mmccoyd/hillside/doc/design.md

Drill tollerence is typically +- 2 mills
Hotswap mill-max sockets need 60 mill min hole
So created footprint with 62 mill holes.
