mmccoyd/hillside/hillside46/doc/image/hill46_keys.png

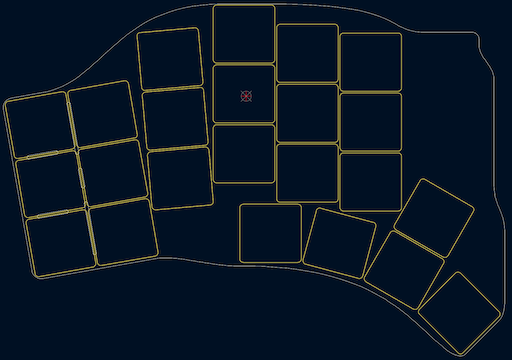
hillside46/doc/image/hill46_keys.png
