mmccoyd/hillside/docs/materials.md

# Materials

## PCB Manufacturing
The gerber and drill files to send to a manufacturer are HERE. Just zip up that folder and order.
Using AllPCB worked fine with order settings of: 10mil trace, 0.4mm via hole, 2 layers, 1.6mm board, 1oz copper, and 98 x 137mm size.

If you would like to make changes, the KiCad files are HERE. 

Cost: $18 plus shipping (for 5 PCBs or 2.5 keyboards).

## Board Hardware

| Part  | Type  | Count | US Shops  | Cost  |
| --- | ----  | ----: | --- | ---: |
| MCU | Elite-C, etc | 2 |  Keebio, MKUltra, LittleKeyboards | $36  |
| Diodes | 1N4148 SOD 123 | 48  |  MKUltra(F), Keebio  | $4 |
| Reset Switch  | MJTP1117 | 2 | Keebio | $1 |
| TRRS Jack | MJ-4PP-9 or PJ-320A | 2 | Keebio | $1 |

## Switches, Keycaps, Cables

You'll need switches, keycaps and a USB cable. The halfs can be connected by a common TRS cable or a more rare TRRS one. 

| Part  | Type  | Count | US Shops  | Cost  |
| --- | ----  | ----: | --- | ---: |
| Switches | Choc v1 | 48 |  MKUltra, LittleKeyBoards  | $33 |
| Keycaps | Choc v1 | 48 |  MBK at: MKUltra (B, W, Colors), LittleKeyboards(BW big kit, Legend, Glow)  | $19 |
| TRS or TRRS cable | 3.5mm  | 1 | TripLite (angled or straight plastic, one foot), Keebio(straight brass, metal sleeved, three foot), ZapCables(custom, metal jack), Mouser SparkFun (plastic 90, one foot)| $7 |
| USB-C cable | | 1 | |  $12 | 

# Optional Additions

## Board Hardware

The simpilist use is flat on a desk, for which some small silicon feet will keep the pin bottoms and your desk separate. You can also add LEDs for visual feedback. As insurance against a damaged MCU bricking half of the keyboard, you can socket each MCU.

| Part  | Type  | Count | US Shops | Cost  |
| --- | ----  | ----: | --- | ---: |
| Silicon Feet | | | Amazon | $5 |
| LEDs | SK6812-MINI-E | 10 | [Digi-Key](https://www.digikey.com/en/products/detail/adafruit-industries-llc/4960/14302512), Keebio, CustomKBD, Adafruit | $3 |
| MCU header sockets | Mil-Max Ultra Low header: 315-43-112-41-003000 | 4 | [Digi-Key](https://www.digikey.com/en/products/detail/mill-max-manufacturing-corp/315-43-112-41-003000/4455232), LittleKeyboards | $13 |
| MCU pins | Mil-Max pin: 3320-0-00-15-00-00-03-0 | 48 | [DigiKey](https://www.digikey.com/en/products/detail/mill-max-manufacturing-corp/3320-0-00-15-00-00-03-0/4147392), LittleKeyboards |  $5 | 

## Haptic Feedback

If you'd like tactile feebback of keypresses or modes, you can mount a haptic board above the MCU. 

| Part  | Type  | Count | US Shops  | Cost  |
| --- | ----  | ----: | --- | ---: |
| Pomeroni Haptic Buzzz | PIM452 | 1 | [Digi-Key](https://www.digikey.com/catalog/en/partgroup/drv2605l-linear-actuator-haptic-breakout-board/90539) | $15 |
| I2C Resistors | 0805 4.7 kOhm 5% 1/8W to 1/4W | 2 | [Digi-Key](https://www.digikey.com/en/products/detail/RC0805JR-074K7L/311-4.7KARCT-ND/731274) | $1 |
| Board spacer | M2.5 x 8mm | 1 | [Digi-Key](https://www.digikey.com/en/products/detail/970070154/732-12831-ND/9488535) | $1 |
| Bolts | M2.5 .45 x 4mm | 2 | [Digi-Key](https://www.digikey.com/en/products/detail/29300/36-29300-ND/2746317) | $1 |

## Tenting Hardware 

Tenting the halfs can be much more ergonomic. You can do that with a book, some blocks of wood, or with a tenting puck and more sophistocated camera mounting components.

| Part  | Type  | Count | US Shops  | Cost  |
| --- | ----  | ----: | --- | ---: |
| Tenting Puck | SplitKB | 2 | [SplitKB](https://splitkb.com/collections/keyboard-parts/products/tenting-puck) | $35 |
| Tenting screws  | M2 | 8 | McMasterCarr | |
| Camera micro-tripod or mounting arms | 1/4" threaded | 2 | various photo shops, [SplitKB](https://splitkb.com/products/manfrotto-pocket-tripod) |$40 |
