mmccoyd/hillside/(threads)

Thread 1 (2022-03-29):

Slave-side key presses are not registered by master side

jurgen-kluft, 2022-03-29:
Current situation:
Left and right board soldered diodes + reset + TRRS + socketed Pro Micro.
Both sides have a Pro Micro flashed with default firmware (cooked by 'https://config.qmk.fm')
Both the left and right side work by themselves, all keys are working.

When testing for continuity (USB disconnected) and TRRS connected, the 'data' pin of the left Pro Micro is connected to the right Pro Micro 'data' pin. VSS and GND are also showing continuity.

So currently I suspect the firmware to not recognize that it should act as 'slave'.

Any suggestions/pointers are very much appreciated at this point.

jurgen-kluft, 2022-03-29:
For my master/slave boards with Pro Micro I had to add the following define into config.h:
#define SPLIT_USB_DETECT

This solved the issue of the master not receiving slave key presses since the slave side did not recognize itself correctly as slave.

mmccoyd, 2022-03-29:
From your other issue #2, it seems you are running a much earlier version of QMK. The split is defined in info.json, which is likely not read correctly by a much earlier version of QMK.

mmccoyd, 2022-03-29:
I'll create a test keymap with a keymap.c in the morning. The default keymap.json creates a simple keymap.c in the .build directory, but an explicit test and example is better.

jurgen-kluft, 2022-03-29:
Same here, will do a run with and without that define to see if the issue is reproducible now with the new QMK firmware.

jurgen-kluft, 2022-03-30:
I have removed/added my fork as well as my installation of QMK so I am now on the latest version `QMK Firmware 0.16.7`.

I tested as follows:
1) Compile my custom keymap for Hillside, test left-side and right-side
2) Add `#define SPLIT_USB_DETECT` to my config.h, compile and test left/right side

Only with 2) am I able to get key presses registered from the slave side.

Note: you can find my hillside keymap here: github.com/jurgen-kluft/qmk-keyboards/hillside

mmccoyd, 2022-03-30:
Your keymap is a _tad_ complex, though worthy of further study. I believe SPLIT_USB_DETECT is old and no longer needed. Turning it on or off did not seem to affect the below keymap.

Here is a simple .c based default that I'll create a PR for in a bit. It builds cleanly with 0.16.7. It includes a commented out line in config.h to set MASTER_RIGHT. I have it in 0_1/keymaps/, but it seems to work fine in keymaps/. As is it works fine with left connected. With the MASTER_RIGHT uncommented it works fine with right connected.
[default_dot_c.zip](https://github.com/mmccoyd/hillside/files/8376784/default_dot_c.zip)

Let me know if this default_doc_c works for you. What stood out to me in yours was the KYRIA_TO_HILLSIDE_LAYOUT mapping.

(My in-process design avoids this left right nonsense with a diode. Something I need to change on this PCB.)

jurgen-kluft, 2022-03-30:
From the conversation I had with Drasha, he mentions this "because a lot of the newer pro micro clones don't properly detect vbus levels". That means that indeed the slave will presume that it is master and that is exactly what I am seeing. So it is a hardware dependency, if you have these kind of Pro Micros you might need to define SPLIT_USB_DETECT.

https://docs.qmk.fm/#/feature_split_keyboard?id=hardware-configuration-options

In what way did this stand out to you? `What stood out to me in yours was the KYRIA_TO_HILLSIDE_LAYOUT mapping.`

mmccoyd, 2022-03-30:
Drasha knows far far more than I do, but the board has fixed master behavior. It _is_ master left, as I understand and designed, unless it is told in config to _be_ right. So I'm not sure how a clone hardware issue could confuse that.

On the mapping, just that that looked like an extra layer of complexity that would be easy to get wrong. Though unlikely to make one side not work. So not really an issue for this problem.

mmccoyd, 2022-03-30:
Ahh, well it is fixed based on config defaults for the board. If the keymap changes those defaults, then that no longer holds.

jurgen-kluft, 2022-03-30:
Yes I understand that, but to get back to basics, when I use the default hillside keymap my slave side doesn't work. Then adding SPLIT_USB_DETECT to the default keymap fixes it.

You can clearly see in the QMK code that SPLIT_USB_DETECT will identify master by actual USB activity and not by reading vbus.

mmccoyd, 2022-03-30:
Oh,  I thought it _did_ work with the default, but not with your keymap.

What about with the default_dot_c keymap folder, if you set MASTER_RIGHT in config.h?
And alternatively explicitly MASTER_LEFT?

If it is a hardware issue, I'm not sure of a solution beyond explicit config, or new hardware.

mmccoyd, 2022-03-30:
I'm assuming the code and hardware should be able to distinguish between noise vs data in from USB or TRRS and decide based on fixed master assignment what it should then do.

mmccoyd, 2022-03-30:
Did not mean to close it, fumble fingered.

jurgen-kluft, 2022-03-30:
I am sure this is not a hardware issue, for me the only suggestion I can give at this moment is for you to add a note in your documentation about this so that people using Pro Micro MCU's can avoid this specific issue.

I will test the zip that you posted and use MASTER_RIGHT although I am sure that this also will work. However this makes it more involved and risky as a user to flash the firmware correctly since you have to do a 'compile/flash/change/compile/flash'.

In your documentation I suggest you add the comment to enable/add SPLIT_USB_DETECT to their own config.h when they use Pro Micro MCU's.

mmccoyd, 2022-03-30:
Huh. You flash the same firmware to both sides. You do have to pick which side you want the cable to go on though.

I'll get a pair of Pro-micros to test. But you mentioned _bad_ clones. If the issue is bad clones, that is separate.

In any case, I'll add some trouble shooting notes. Thanks for the feedback and sorry it did not work quite right with your boards.

jurgen-kluft, 2022-03-30:
Thanks Michael, to be honest the board is great, like the minimal feel and the low profile. So I should be the one thanking you for putting in the design work, the detailed documentation and making it open-source.

Thank you !

Note: Drashna directed me to read this article if I was interested in the details (and trouble) on how the split code is determining master/slave.
https://medium.com/@keebio/the-case-of-the-wayward-elite-c-73f0fd691f88#3bf5

mmccoyd, 2022-03-30:
Thanks! Creating it scratched an itch and having other people actually use it is really awesome. I have a version in the works that uses a diode in the key matrix on one side to know which side is which, and which has a slight ring and pinky finger splay. Once that is out I'll update this version with the same handedness detection. Hopefully one of all these works out for you.

I'll read up on that article. Thanks. I do remember a while ago reading about voltage levels detection and what not.

Closed 2022-04-04.

Thread 2 (2022-03-29):

QMK: compiling directly with 'qmk compile' gives errors

jurgen-kluft, 2022-03-29:
[qmk_compile_hillside_errors.log](https://github.com/mmccoyd/hillside/files/8369077/qmk_compile_hillside_errors.log)

These errors can be fixed by adding the following into config.h, however this does have qmk spew out warnings.
#define VENDOR_ID       0xFEED
#define PRODUCT_ID      0x67C0
#define DEVICE_VER      0x0001
#define DIODE_DIRECTION COL2ROW
#define RGBLED_NUM 5
#define RGB_DI_PIN D3
#define SOFT_SERIAL_PIN D2

Furthermore if the following is not defined in config.h then no key is registered:
#define MATRIX_ROW_PINS \
    { D7, E6, B4, B5 }
#define MATRIX_COL_PINS \
    { F6, F7, B1, B3, B2, B6 }

By adding all of the above in 'config.h' my own firmware/keymap works, can be compiled and flashed and registers all keys.

mmccoyd, 2022-03-29:
Jurgen, Thanks for the report.

It looks as if you are running a much older version of QMK. Your error log lists QMK Firmware 0.12.50, while  0.16.0 started in February. Recent changes have more more config into info.json, which is likely not read correctly by prior versions.

jurgen-kluft, 2022-03-29:
Hi @mmccoyd,

Yes you are right, after upgrading QMK (correctly this time) it does indeed not complain anymore.

Closed 2022-03-29.

Thread 3 (2022-03-29):

USB split detect, master/slave is not detected correctly

jurgen-kluft, 2022-03-29:

mmccoyd, 2022-03-29:
It seems you are running a much older version of QMK, 0.12.50 instead of the current  0.16. Updating would likely make this addition unnecessary.

Thread 5 (2022-04-12):

Build guide doesn't include information about wireless builds

rmwphd, 2022-04-12:
The build guide for the Hillside is fantastic, but it's missing a page describing how to hook up the battery, off switch, and capacitor. Which set of batt pos / gnd do you solder the battery leads to?

It's also missing info about closing the jumper for i2c things on the page on adding the resistors.

rmwphd, 2022-04-16:
For those seeking info: The capacitor solders on near the top of the MCU area. Soldering the battery leads to the top pads on the PCBs, near the USB-C ports on your nice!nano, works. The on-off switch goes on just like you imagine it does.

I don't have the Pimoroni trackball working in ZMK on my board yet, so I don't know if I did the right thing by closing the jumpers on both halves for i2c yet.

mmccoyd, 2022-05-27:
Sorry I missed this. I added a wireless page to the build guide. And a page explaining the accessory power jumper.

Closed 2022-05-27.

Thread 6 (2022-05-26):

Add hillside to splitKbCompare

azzamsa, 2022-05-26:
https://github.com/jhelvy/splitKbCompare/issues/85

azzamsa, 2022-05-26:
Also, should we export https://github.com/mmccoyd/hillside/blob/main/doc/image/hillside-switches_left.svg to PDF to avoid user confusion on what scale/paper it needs to be printed?

azzamsa, 2022-05-27:
https://github.com/jhelvy/splitKbCompare/pull/71

Closed 2022-05-27.

Thread 10 (2022-10-07):

Hillside 48 upgrade

Lumi317, 2022-10-07:
The Hillside 48 seems to get less attention than the Hillside 46.
Would it be possible to update the Hillside 48 so that it has more encoder spots, the hotswap option, and a PCBA?

alejoar, 2024-02-25:
Hotswap is the only thing missing for the 48 to be my next build!

alejoar, 2024-02-26:
https://github.com/Painterman/Cardinal

Thread 9 (2022-10-07):

Only USB-C ports

Lumi317, 2022-10-07:
Would it be possible to create variations of the Hillsides whose TRRS ports are replaced by USB-C ports?

mmccoyd, 2022-11-06:
I continue to think about USB, but I'm not there yet. There are a few factors:

- Pro:
  - It solves worry about frying things when un/plugging the two sides.
  - PCBA is easy enough to set up as I use it for other parts of the boards.
- Con:
  - USB-C forces the more expensive PCBA over hand soldering for everyone. The drag soldering needed for USB-C  is unlikely to be at all feasible those new to soldering or with less optimal equipment or solder.
  - Managing two versions of four boards, for a TRRS or USB solution to that, is non trivial.
  - Micro USB is a possible option that:
     - may still be hand solderable or can share a TRRS footprint.
     - has a few cables available, but not that many, and may fade to history longer term.
  - The MCU must be rewired, likely to RAW instead of VCC. A minor issue.

I may make the switch, as bare boards are not that much cheeper than PCBA, but some other improvements are higher on the list. But thanks.

Lumi571, 2022-11-08:
From my point of view, the USB-C version should just replace the TRRS version rather than maintaining two versions. I think people who are into soldering by hand wouldn't mind giving up manually soldering a TRRS port if it brings the qualities of USB-C to their hardware.
Here is a discussion about it on Reddit that might interest you: https://www.reddit.com/r/ErgoMechKeyboards/comments/rt083u/as_a_reminder_while_the_usb_is_plugged_do_not/

mmccoyd, 2022-11-08:
A good discussion, though not anything new. As Thomas says, debate for relacing it has been ongoing.

mmccoyd, 2022-11-08:
A new addition to the factors list:

- Preventing phone plugged into split connect negotiating higher voltage charge from desktop through keyboard and thus frying keyboards MCU. Should just be by not passing those negotiation circuits to the split connection.

Thread 13 (2022-10-30):

jlcpcb has issues reading gerber files for 52 & 56

tsteffek, 2022-10-30:
I just wanted jlcpcb to make me some hillside52 PCBs, when I realized that they don't produce sensible prices. I checked the gerber view, and while it does present you with the board in the preview, the logging on the side tells you:
```
Analysis Results
layers : -1
minimum trace width : >=10 mil
minimum trace spacing : >=10 mil
minimum drill size : null
width : null
height : null
Unable to identify the layers due to the non-standard filename
Can not identify the board outline
...
```
I've tried with 56 for the same result and compared those to 46 and 48, which both seem to work (gets correct pricing, and Gerber Viewer doesn't complain about anything).

Disclaimer: This is my first time ordering PCBs and I have no idea what I'm doing, so while it's completely possible I messed up somewhere, I always thought downloading and uploading a .zip was fool-proof :D

mmccoyd, 2022-10-30:
Sorry about that. I get the same result, which should not be the case.
I'll shift to making them the same way I make the 46 files, which will give you a PCBA option as well if you want it.
That might take a day or so.
Thanks for the issue report!

tsteffek, 2022-10-31:
That would be more than I ever dreamt of! Thank you.

mmccoyd, 2022-11-03:
I pushed a fix for this to https://github.com/mmccoyd/hillside/releases.

The wiki is updated on how to order them, it is now the same as for the 46.

Please let me know if that works fine for you! I've tested it with the JLC PCBA parts selection and preview steps for both front and back PCBA.

mmccoyd, 2022-11-03:
I fixed it for the 52. Not yet for the 56...

mmccoyd, 2022-11-08:
I'm fixing this for 56, which will also enable PCBA for it and put its Gerber and PCBA files on the releases page. Though its firmware will still be on a fork, not yet in QMK main.

Thread 14 (2022-11-03):

PCBA files for 52?

ramnathk, 2022-11-03:
Hi there, could you publish the PCBA files for the 52 key version of the keyboard please?

mmccoyd, 2022-11-03:
Done I believe. They are in the zip in the release.

It is a prerelease, in that I have not physically tested it, and likely will not get to. But it displays properly in JLC order system. It should work fine. Please let me know if it works for you or you have any issues with it. Then I can remove the prerelease marking.

mmccoyd, 2022-11-03:
It was a issue fix for JLC no longer liking the Gerber files. But PCBA got added to it.

ramnathk, 2022-11-04:
Awesome and than you mate

Closed 2022-11-05.

Thread 16 (2022-11-26):

Add more parts to PCBA

auipga, 2022-11-26:
Hi,
first of all, thank you for this sophisticated piece of awesomeness! Even the LEDs are hidden _behind_ a key. You're a genius!

I've read the Wiki and if I'm right I need to solder some parts myself after PCBA service:
- SK6812MINI-E https://jlcpcb.com/partdetail/OpscoOptoelectronics-SK6812MINIE/C5149201
- Rotary Encoders https://jlcpcb.com/partdetail/Alpsalpine-EC12E1220301/C209763
- Machine pin female sockets like this https://www.mouser.de/ProductDetail/Mill-Max/315-43-112-41-003000?qs=s8Nb1z4Wn%2FRfWrVqQ0TOuQ%3D%3D
- Mill-Max Hot Swap Sockets https://jlcpcb.com/partdetail/millmax-7305_0_15_15_47_27_100/C5189908

Is it possible to add those to the PCBA too?
Regards

mmccoyd, 2022-11-26:
Hi. Thanks.

A short reply for the moment.

The LEDs could be possible, but they are only supported for the Standard PCBA process, not the Economical one. Which raised the setup price from a modest $8 per side to $25 per side. They are one of the more challenging bits to solder, so it might be good idea, if I can prevent it causing confusion for the normal Economical PCBA process. Thanks.

A risk of adding the encoders to the PCBA is that people who did not really want encoders might still just send the files as is without checking them and deselecting the encoders. I'd say encoders are as easy to solder as switches, and more of a pain to desolder.

A different PCBA manufacturer provides more capabilities, but at higher price. I've not yet looked at using them. I expect they could do the MCU sockets, but I'm not sure about the switch Mil-Max.

auipga, 2022-11-27:
Hi Michael. Thank you for your detailed reply.

The LEDs would be the most interesting. What I didn't understand is whether the more expensive standard PCBA Type is evitable or not.

The rest would be ok to solder myself.

auipga, 2022-11-30:
Now that I decided to pay that price for the standard PCBA type, I'd like to add whatever is possible.
Could you help me achieve this / guide me through the process?
All I can get to is this:
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

What is the correct way to add and position new parts to existing footprints?

mmccoyd, 2022-11-30:
Hi. I'm adding that to the release zip, thought it might be a day or two.

Either of the power switches should be fine. Moving to oval holes expanded the switch choices, but I've not fully updated the docs yet.

auipga, 2023-01-09:
Hi, just wanted to ask whether I can do something for you to get it done?

Closed 2023-02-22.

Thread 17 (2022-11-26):

[Somebody interested?] Bigger battery on board

auipga, 2022-11-26:
It's just an idea, not yet as sophisticated as your work ;)
But fixing an empty battery within 5 seconds replacing it, putting the empty one into the charger and use it for weeks/months before you need to repeat? Sounds good to me.

https://www.amazon.de/-18650-battery-holder/dp/B081HW4TGR

Pinta crashed while painting mockup :'( So here's the text-only-edition:
I'd place the battery right above the first thumb key with enough space for an OLED ;)
What do you think?

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

johannes-jp, 2024-12-06:
Hey I did this! With my placement it fills the space underneath the palm, and stays out of the way of the thumb. I didn't want it on the inside between the boards, because I prefer to use that space for a mouse.
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
It doesn't look very nice and I made a 3d model for doing it properly, which I can upload when I find it.

auipga, 2024-12-21:
Looks promising :) thanks for sharing

tokazio, 2024-12-31:
I've used 3000mAh flat one.
At the top back that give some tenting 😉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

(The keyboard is a sofle choc but i've done the same thing on my dailly hillside)

Thread 18 (2022-11-27):

Which switch is correct?

auipga, 2022-11-27:
1. [Wiki](https://github.com/mmccoyd/hillside/wiki/Wireless%20Nicenano%20Parts#nicenano-wireless-mcu) says JS202011AQN / [C221662](https://jlcpcb.com/partdetail/ck-JS202011AQN/C221662)
2. [hilside52_bom.csv](https://github.com/mmccoyd/hillside/releases/tag/ver%2Fhill52_0.1.1-rc1) says SSSS223200 / [C115376](https://jlcpcb.com/partdetail/Alpsalpine-SSSS223200/C115376)

Is this a mistake?
Does it matter?
Is the only difference the color of the handle piece? 1 black, 2 white

auipga, 2022-12-02:
As answered [here](https://github.com/mmccoyd/hillside/issues/16#issuecomment-1332827521):
> Either of the power switches should be fine. Moving to oval holes expanded the switch choices, but I've not fully updated the docs yet.

Closed 2022-12-02.

Thread 19 (2023-01-01):

right half does not work with stock (52) zmk firmware

ramnathk, 2023-01-01:
Hi there I just finished assembling my hillside 52. The right half does not work when I flash it with the right nice nano firmware. However, if I flash it with the left's firmware, it works. What is amiss? As I understand I can leave the handedness jumpers open as ZMK handles it in software. So, what's the issue?

I use the QMK configurator's keyboard tester to test for keystrokes
Cheers,
Karthik

autoferrit, 2023-05-22:
i am planning on ordering the 52 to use with zmk and nice nanos. did you ever figure this out?

auipga, 2023-05-31:
@ramnathk I'd guess, that you tried mmccoyd's default firmware and settings_reset. You could provide your firmware.zip and I'll try it on mine, just to ensure it's a hardware situation. I would also try to switch the controllers in case you used the socket option.
@autoferrit mine works, so it's not a general problem.

autoferrit, 2023-06-01:
got it. i did have an issue with it working with the nice nanos after the recent zephyr update. but i managed to update the `config/boards/shields/hillside52/nice_nano_v2.overlay` and got it to compile properly. so it seems to be working so far. though I just did this and might need to be tested more.

tokazio, 2023-10-13:
@autoferrit i have the same problem, what have you done to make the right part work please ?

Thread 20 (2023-03-13):

How to mount encoder

tim-hilt, 2023-03-13:
I have ordered all required parts to build my Hillside. The only thing I don’t really know with is how to solder the encoders. One of the holes in the PCB doesn’t seem to be wide enough.

Here’s a photo of what I mean:

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

How am I supposed to deal with this? Do I just cut off the second wide leg?

mmccoyd, 2023-03-14:
Tim, Yes, just cut off the circled wide leg. I'd update the docs if it's not there. A wide leg hole and LED would not go well together. I hope you like the board.

tim-hilt, 2023-03-14:
Thanks for the response! :) I’m very excited to see how the Hillside works for me! Thank you!

Closed 2023-03-14.

Thread 21 (2023-04-12):

JLCPCB's PCA preview shows Hillside 46 components misplaced

jfhector, 2023-04-12:
Hello!

Thanks a lot for this wonderful looking keyboard, and the very helpful detailed instructions!

I'm following the instructions on the [Ordering Hillside 52 or 46 page](https://github.com/mmccoyd/hillside/wiki/Ordering%20Hillside%2052%20or%2046), in order to order a Hillside 46 from JLCPCB.

I'm following the steps detailed in the doc step by step, but after uploading the BOM and top_boards.csv, JLCPCB's preview shows the components positioned completely off the PCB:

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

This seems to be the only preview JLCPCB shows before placing the order. I've redone the steps three times and I don't think I've missed anything. Is it the case that I've missed anything, or is there an issue with JLCPCB or with the instructions?

### Steps to reproduce

1. Download hillside46-gerber-and-pcba_0.1.0 from [Releases](https://github.com/mmccoyd/hillside/releases) [hill46_v0.1.0](https://github.com/mmccoyd/hillside/releases/tag/hill46_v0.1.0).

2. On JLCPCB, follow the instructions from [How to Order Five PCBA Keyboards](https://github.com/mmccoyd/hillside/wiki/Ordering%20Hillside%2052%20or%2046#how-to-order-five-pcba-keyboards)

    Side note: The instructions say "Dimensions: 100 x 143 mm". But after uploading the Gerber file, dimensions are pre-populated and are slightly different: 142.49 width, 99.87 height.

3. At the 'Save to Cart' step, which reads ...
    > The preview should show components placed and rotated over spots on the board that look meant for them, in terms of silkscreen lines around them and traces leading to them. The engineers will ensure the final placement, and you will confirm at DFM Analysis later.

    ... the components on the preview are placed away from the PCB board.

jfhector, 2023-04-12:
Looking at other people's experience, it may be an issue with JLCPCB's viewer, and the assembly may come back fine:
https://www.eevblog.com/forum/manufacture/jlcpcb-smt-weird-issue-with-part-placements/

jfhector, 2023-04-12:
JLCPCB have posted a blog post which seems to be about that issue, with reassurance that it's fine:
https://github.com/JLCPCB/JLCPCB-SMT-Assembly-Components-orientation-fix

I'm closing the issue as I don't expect this is a problem with the instructions in this repo.

Max-Stevens, 2023-05-07:
On the note of the part misalignment, the placement for U2 isn't very clear so I'm concerned that the orientation might be incorrect when the placement is imported.

Would it be possible to please include a note or picture somewhere in the guide to show the correct orientation of U2 on the top and bottom boards?

auipga, 2023-05-08:
I had this too, though not in the preview but confirmation via email. I used 'confirm parts placement' option (as recommended) and they showed their skills by automatically sending me pictures of corrected placements. They won't beginn the production if you don't confirm that so my guess is you won't lose your money by just trying.
The final product works as intended. (hillside52)

jfhector, 2023-06-16:
Hello!

I've now placed and received my PCB Assembly order from JLCPCB.

I can confirm that there was no issue at all.

Specifically, in spite of the fact that the components were mis-positioned (a rotation issue) on the preview at the time of ordering:
- I received an email a few hours after ordering to ask me to check the corrected positioning. On that new visualisation the positioning was correct. If it hadn't been, I would have been able to ask for changes.
- The PCB I've received has the parts positioned in the correct way.

So, I'm closing this issue.

Also, I want to say that I'm very grateful for and impressed by both the design of Hillside, but also the thoughtful comprehensive documentation. Both were reasons why I've chosen to build Hillside 46 as my first keyboard, and I'm very excited about it. It's very close to the perfect keyboard for me. Thanks!

Closed 2023-06-16.

Thread 25 (2023-07-16):

Is the C1 decoupling capacitor necessary for a Nice!Nano build?

cbuhl79, 2023-07-16:
I'm building a wireless Hillside 52 using a kit from Beekeeb. The kit didn't come with a capacitor, and the Parts list says that capacitors are needed only for the Hillside 46 (presumably, this is for the C2 and C3 capacitors on that board though).

Is this capacitor necessary? Is it just a safety measure?

cbuhl79, 2023-07-17:
I found the answer here:
https://github.com/mmccoyd/hillside/wiki/Wireless%20Nicenano%20Parts

> The capacitors mitigate power surge when turning on the battery. They are already present on the nice!nano MCU, so are not needed with that wireless MCU

cbuhl79, 2023-07-17:
I found the answer here:
https://github.com/mmccoyd/hillside/wiki/Wireless%20Nicenano%20Parts

> The capacitors mitigate power surge when turning on the battery. They are already present on the nice!nano MCU, so are not needed with that wireless MCU

Closed 2023-07-17.

Thread 26 (2023-07-17):

PCB Giveaway [EU/DE]

auipga, 2023-07-17:
Hi community,

The hillside52 keeb is **by far** the best keyboard I have ever used. In my opinion it really deserves more attention.

That's why I decided to gift 8 of my left over PCBs to 4 kind people who want to build their own but dread the ordering process.
All you need to pay for is shipping. Therefore it is the cheapest if you live in Germany. (~5 €)

You can contact me via Telegram. My usernames at GitHub and Telegram are the same.

Regards
Manuel

Received PCBs:
1. @johannes-jp
2. @tokazio

auipga, 2023-09-10:
still available:

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

tokazio, 2023-09-11:
I'm interested

tokazio, 2023-09-12:
I've contacted you on telegram

johannes-jp, 2023-09-12:
Mine have arrived! Thank you very much @auipga. It would have been smart for me to get tracking, but they found their way to Finland nonetheless :D

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

auipga, 2023-09-12:
strange... if @tokazio is your name here and for telegram then you got a message.

tokazio, 2023-09-13:
Yes it's good

tokazio, 2023-09-30:
Received today, awesome
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

Big thanks @auipga

julientaq, 2023-11-21:
hey there.

do you still have pcb? i want to test it to try an alternative to my ferris?

auipga, 2023-12-20:
The give away is over. All PCBs have found a new home. I'm happy to see what you are creating. I'd also be interested in your keymaps.

If you have questions or need help building I'll do my best to assist.

julientaq, 2023-12-20:
thanks a lot @auipga!

we’ll put pictures here ⌨️

tokazio, 2023-12-26:
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

Closed 2023-12-20.

Thread 27 (2023-10-26):

Only USB-connected half is working after trying to enable VIA

elentok, 2023-10-26:
Last week I finished building my Hillside 46. I'm using two Type-C ProMicros from [Aliexpress](https://www.aliexpress.com/item/32846843498.html).

It worked for a couple of days with the default keymap, I had some issues with the left side working as the right side but I fixed it by adding these two lines to the `keymaps/default/config.h` file:

```
#undef SPLIT_HAND_MATRIX_GRID
#define EE_HANDS
```

I'm compiling with this command:

```
qmk compile -kb hillside/46/0_1 -km default
```

And flashing (each side separately):

```
qmk flash -bl avrdude-split-left hillside_46_0_1_default.hex
qmk flash -bl avrdude-split-right hillside_46_0_1_default.hex
```

Today I wanted to switch the C keymap and I also set `VIA_ENABLE = yes` in `keymaps/default/rules.mk` (not sure why I did both of these changes together, it might have been a dumb idea).

After flashing both sides I noticed only the side connected via USB is working:

- The keys on the other side don't do anything
- The underglow LEDs on the other side don't start
- The ProMicro LED does turn on

When connecting the left side standalone it worked fine, but when connecting the right side standalone it behaved like the right side.

After flashing the original firmware I used and clearing the EEPROM using QMK Toolbox didn't work I found a tip about setting the handedness via QMK Toolbox and that fixed the right side problem.

But still only the USB-connected half is working...

- I checked the VCC->GND voltage on the other half and it's 5V
- I tried resetting the EEPROM (from QMK Toolbox and by mapping a key to QK_CLEAR_EEPROM)

Any suggestions?

EDIT: This is the output when flashing:

```
❯ qmk flash -bl avrdude-split-right hillside_46_0_1_default.hex

Flashing binary firmware...
Please reset your keyboard into bootloader mode now!
Press Ctrl-C to exit.

avrdude: AVR device initialized and ready to accept instructions
avrdude: device signature = 0x1e9587 (probably m32u4)
avrdude: Note: flash memory has been specified, an erase cycle will be performed.
         To disable this feature, specify the -D option.
avrdude: erasing chip

avrdude: processing -U flash:w:/Users/david/qmk_firmware/hillside_46_0_1_default.hex:i
avrdude: reading input file /Users/david/qmk_firmware/hillside_46_0_1_default.hex for flash
         with 18256 bytes in 1 section within [0, 0x474f]
         using 143 pages and 48 pad bytes
avrdude: writing 18256 bytes flash ...
Writing | ################################################## | 100% 1.38 s
avrdude: 18256 bytes of flash written
avrdude: verifying flash memory against /Users/david/qmk_firmware/hillside_46_0_1_default.hex
Reading | ################################################## | 100% 0.14 s
avrdude: 18256 bytes of flash verified

avrdude done.  Thank you.
```

elentok, 2023-10-27:
Never mind, I needed to add `#define SPLIT_USB_DETECT`:

```
/* Split */
// #define SPLIT_HAND_MATRIX_GRID B5, F6
// #define MATRIX_MASKED
#define EE_HANDS
#define SPLIT_USB_DETECT
```

Closed 2023-10-27.

Thread 29 (2023-11-20):

Files for PCBA not compatible with JLCPCB

dalewking, 2023-11-20:
Apparently JLCPCB has changed their process for specifying parts placement. They now require separate BOM and CPL files and the file in the release do not work.

Looks like I was able to make it work by splitting the file into 2 files

I made a the BOM file by deleting the placement information and changing the Package header to Footprint and Val column to Comment.

I made a CPL file by deleting the Package and Val column.

Thread 31 (2023-12-10):

Mill-Max Hot Swap Sockets?

krip77, 2023-12-10:
I can't find any specs or product code for the hot swap sockets.

auipga, 2023-12-10:
These worked for me: https://keygem.com/products/mill-max-hot-swap-sockets?_pos=1&_psq=7305&_ss=e&_v=1.0&variant=36531902120102

pedroren, 2024-12-06:
> These worked for me: https://keygem.com/products/mill-max-hot-swap-sockets?_pos=1&_psq=7305&_ss=e&_v=1.0&variant=36531902120102

Sorry, the 7305?

auipga, 2024-12-21:
@pedroren yes. I ordered exactly those and soldered them. They fit.
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

Thread 32 (2023-12-20):

Problem with JLCPCB production of hillside46 keyboard

jittapont, 2023-12-20:
Hi,
I got an email from JLCPCB that said the hole in the PCB didn't align with the copper pad in the keyboard (shown in the white circle in the pictures). Is this fine to proceed with the production or I need to fix this by myself 😢
Thanks in advance!

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

daniel2887, 2024-07-14:
Did you every figure this out? Or did you process and the PCB ended up ok?

Thread 33 (2024-02-07):

Problem flashing Sea Micro (atmega32u4) using DFU

gbThreepwood, 2024-02-07:
I just received a hillside48 with a Sea Micro atmega32u4 USB-C microcontroller (ordered on beekeeb), and I experienced some challenges uploading the QMK firmware using DFU. I think I have solved the problem (or at least found a workaround), but I still have not gotten around to solder the keys to my keyboard and tested it, so I will have to write a update once that is completed.

**Tldr: use avrdude to flash the MCU**

My problem was when running the `qmk flash` command.

```
~ qmk flash
Ψ Compiling keymap with make -r -R -f builddefs/build_keyboard.mk -s flash KEYBOARD=hillside/48/0_1 KEYMAP=gbthreepwood KEYBOARD_FILESAFE=hillside_48_0_1 TARGET=hillside_48_0_1_gbthreepwood INTERMEDIATE_OUTPUT=.build/obj_hillside_48_0_1_gbthreepwood VERBOSE=false COLOR=true SILENT=false QMK_BIN="qmk"

avr-gcc (GCC) 13.2.0
Copyright (C) 2023 Free Software Foundation, Inc.
This is free software; see the source for copying conditions.  There is NO
warranty; not even for MERCHANTABILITY or FITNESS FOR A PARTICULAR PURPOSE.

Size before:
   text	   data	    bss	    dec	    hex	filename
      0	  18082	      0	  18082	   46a2	hillside_48_0_1_gbthreepwood.hex

Copying hillside_48_0_1_gbthreepwood.hex to qmk_firmware folder                                     [OK]
Checking file size of hillside_48_0_1_gbthreepwood.hex                                              [OK]
 * The firmware size is fine - 18082/28672 (63%, 10590 bytes free)
Flashing for bootloader: atmel-dfu
Bootloader Version: 0x00 (0)
Checking memory from 0x0 to 0x6FFF...  Empty.
Chip already blank, to force erase use --force.
Checking memory from 0x0 to 0x46FF...  Empty.
0%                            100%  Programming 0x4700 bytes...
[ X  ERROR
Memory write error, use debug for more info.
make: *** [platforms/avr/flash.mk:173: flash] Error 254

```

Directly calling the `dfu-programmer` software gives the same error:

```
dfu-programmer atmega32u4 flash hillside_48_0_1_gbthreepwood.hex --debug 2
     target: atmega32u4
    chip_id: 0x2ff4
  vendor_id: 0x03eb
    command: flash
      quiet: false
      debug: 2
device_type: AVR
------ command specific below ------
   validate: true
   hex file: hillside_48_0_1_gbthreepwood.hex

Checking memory from 0x0 to 0x46FF...  Empty.
0%                            100%  Programming 0x4700 bytes...
[ X  ERROR
Memory write error, use debug for more info.
```

The following works, and afterwards it seams that the `qmk flash` also started working:
```
avrdude -p atmega32u4 -c flip1 U flash:w:hillside_48_0_1_gbthreepwood.hex
```

I now get the following upon issuing `qmk flash`:

```
Ψ Compiling keymap with make -r -R -f builddefs/build_keyboard.mk -s flash KEYBOARD=hillside/48/0_1 KEYMAP=gbthreepwood KEYBOARD_FILESAFE=hillside_48_0_1 TARGET=hillside_48_0_1_gbthreepwood INTERMEDIATE_OUTPUT=.build/obj_hillside_48_0_1_gbthreepwood VERBOSE=false COLOR=true SILENT=false QMK_BIN="qmk"

avr-gcc (GCC) 13.2.0
Copyright (C) 2023 Free Software Foundation, Inc.
This is free software; see the source for copying conditions.  There is NO
warranty; not even for MERCHANTABILITY or FITNESS FOR A PARTICULAR PURPOSE.

Size before:
   text	   data	    bss	    dec	    hex	filename
      0	  18082	      0	  18082	   46a2	hillside_48_0_1_gbthreepwood.hex

Copying hillside_48_0_1_gbthreepwood.hex to qmk_firmware folder                                     [OK]
Checking file size of hillside_48_0_1_gbthreepwood.hex                                              [OK]
 * The firmware size is fine - 18082/28672 (63%, 10590 bytes free)
Flashing for bootloader: atmel-dfu
Bootloader Version: 0x00 (0)
Checking memory from 0x0 to 0x6FFF...  Not blank at 0x1.
Erasing flash...  Success
Checking memory from 0x0 to 0x6FFF...  Empty.
Checking memory from 0x0 to 0x46FF...  Empty.
0%                            100%  Programming 0x4700 bytes...
[>>>>>>>>>>>>>>>>>>>>>>>>>>>>>>>>]  Success
0%                            100%  Reading 0x7000 bytes...
[>>>>>>>>>>>>>>>>>>>>>>>>>>>>>>>>]  Success
Validating...  Success
0x4700 bytes written into 0x7000 bytes memory (63.39%).
make: *** [platforms/avr/flash.mk:173: flash] Error 254

```

There is still a error 254 message, but at least it seams like some uploading did happen.

gbThreepwood, 2024-02-13:
After finishing the soldering I can confirm that the firmware is working as expected with the workaround in the above issue.

Unfortunately I used a deflux spray on my PCB which apparently contains acetone, so half of my switches are ruined, but I guess I mostly have myself to blame for that...

Thread 35 (2024-12-31):

Keycaps

tokazio, 2024-12-31:
I wanted to share my final hillside kb with you because i've Just received my FK caps.
Fkcaps.com
Less a week to delivers (20€ for douanes🥺)
But the result is awesome
Finally got my hillside finished!
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

jobs62, 2025-04-17:
as a fellow azerty user, i may take inspiration :)

mmccoyd, 2025-08-31:
Very nice. Those keycaps and colors are awesome. Someday I need to get a labeled set like that.

Closed 2025-08-31.
