mmccoyd/hillside/(commit log)

2021-08-20 Project creation
    [zealous_corn.kicad_pcb, zealous_corn.sch]
2021-08-21 Matrix in scheme and PCB, edge cuts, tenting puck
    [zealous_corn.kicad_pcb, zealous_corn.sch]
2021-08-22 - sym/foot: diode-choc
2021-08-22 Two lower row, one upper thumb, 48 keys
    - use project sym/footprint for keys, matrix cols
    [zealous_corn.kicad_pcb, zealous_corn.sch]
2021-08-23 TRRS points up, choc Ferris arc, smooth edges
    - parts for OLED and LED
    - mini SMD reset button
    - silk name and version
    [zealous_corn.kicad_pcb, zealous_corn.sch]
2021-08-25 TRRS with footprint, through hole reset
    - Tenting puck subtler silk
    -
    [zealous_corn.kicad_pcb, zealous_corn.sch]
2021-08-31 Mini-E LEDS footprint, wider right side,
    [zealous_corn.kicad_pcb, zealous_corn.sch]
2021-08-31 All traces connected. Reset footprint
    [zealous_corn.kicad_pcb, zealous_corn.sch]
2021-08-31 Fill areas
    [zealous_corn.kicad_pcb]
2021-08-31 v0.1.0-alpha: show all layers
    [zealous_corn.kicad_pcb]
2021-09-01 Clean up traces
    [zealous_corn.kicad_pcb]
2021-09-01 Revert to switch footprint mask the unused side
    [zealous_corn.kicad_pcb, zealous_corn.sch]
2021-09-01 Use longfir lib not mccoyd for sym and footprints
    [zealous_corn.kicad_pcb, zealous_corn.sch]
2021-09-01 - tenting puck in project lib
    [zealous_corn.kicad_pcb]
2021-09-01 README with Intro, BOM, rationale
2021-09-01 - clean up traces, LED
    [zealous_corn.kicad_pcb]
2021-09-01 TRRS sleeve connect to ground
    [zealous_corn.kicad_pcb, zealous_corn.sch]
2021-09-01 - cleaner LED traces on right
    [zealous_corn.kicad_pcb]
2021-09-01 Rename project to longfir from zealous_corn
    [longfir.kicad_pcb, longfir.sch]
2021-09-01 Remove acid traps
    [longfir.kicad_pcb]
2021-09-01 v0.1.0-alpha.1: PCB and images of schematic, traces, renders
    - diff from last is PCBNew's file churn...
    [longfir.kicad_pcb]
2021-09-09 Fix switch footprint traces, Fix Tenting Puck
    Footprints:
    - Choc-diode traces as lines not custom pads, so show in gerber; diode silk end bar further from pad and mask
    - Tenting Puck screws better clearance
    - Move board label to lower center
    - LEDs Ref# on fabrication layer, not silk
    - Rewire TRRS to work with TRS cables
    - TRRS moved in and up more
    - Smoother curve on lower left edge cut
    - Pads for haptic header
    [longfir.kicad_pcb, longfir.sch]
2021-09-10 Footprint: Haptic 1x5 header, scratch outline
2021-09-11 Use 6 columns. Bottom row traces run two cols over
    - LEDs tucked under top edge of bottom row keys.
    [longfir.kicad_pcb, longfir.sch]
2021-09-11 Pull up resistors for I2C
    - Use bottom plate as ground plate
    - Sym Diode-Choc: suppress pin numbers in schematic
    [longfir.kicad_pcb, longfir.sch]
2021-09-15 footprint: ProMicro added, with updated pin labels
2021-09-15 Footprint: TRRS Jack, MP-4PP-9
2021-09-15 Footprint: Resistor SMT two sided
2021-09-15 Footprint: switch for reset
2021-09-15 Footprint: Choc switch more margin trace to pad
2021-09-15 Scheme: Value and Reference cleanup
    [longfir.sch]
2021-09-15 PCB: Haptic, TRRS, reset angled, smooth edge cuts
    - Haptic on side
    - Reset angled
    - Trace cleanup
    - Edge cuts smooth
    [longfir.kicad_pcb]
2021-09-15 Footprint: Pomononi Haptic
2021-09-15 Keepout area for LED top shine experiment
    [longfir.kicad_pcb]
2021-09-15 Rename project to Redwood from LongFir
    [redwood.kicad_pcb, redwood.sch]
2021-09-18 Footprint: Choc switch vias away from SMT pads
2021-09-18 Footprint: promicro cleanup
2021-09-18 Footprint: resistor trace vias away from SMT pads
2021-09-18 Footprint: Trackball outline and mount points
2021-09-20 Footprint: switch trace cleanup
2021-09-20 Footprint: MCU Encoder pins
2021-09-20 Footprint: LED smaller fab layer font
2021-09-20 - Doc: more materials notes
2021-09-20 Footprint: Haptic tweeks
2021-09-20 Footprint: choc rotary encoder switch
2021-09-20 Footprint: Diode reversible
2021-09-20 Scheme: encoder, symbols for hardware bits
    [redwood.sch]
2021-09-20 Symbols: hardware bits, choc encoder
2021-09-20 PCB: Rotary encoder
    [redwood.kicad_pcb]
2021-09-22 All KiCad files in subfolder
    [redwood.kicad_pcb, redwood.sch]
2021-09-22 v0.1.0-alpha.2: Gerber files update
    [redwood-B_Cu.gbr, redwood-B_Fab.gbr, redwood-B_Mask.gbr, redwood-B_SilkS.gbr, redwood-Dwgs_User.gbr, redwood-Edge_Cuts.gbr, redwood-F_Cu.gbr, redwood-F_Fab.gbr]
2021-09-22 Cleanup symbol references
    [redwood.sch]
2021-10-15 Tenting puck courtyard in center for mount screw
2021-10-15 Promicro only expose pads where need to solder
2021-10-15 TRRS only expose pads where need to solder
2021-10-15 scheme: extra stitching via
    [redwood.sch]
2021-10-15 - doc: materials, future, build
2021-10-15 - project updates from footprints
    [redwood.kicad_pcb]
2021-10-16 Symbols: KiCad symbols and MCU in project lib
2021-10-16 Symbols and footprints all from project libs
    [redwood.kicad_pcb, redwood.sch]
2021-10-19 Footprint: reversible choc w/o diode
2021-10-21 Footprint: choc switch shows inner outline
2021-10-21 Common cathode diodes for key matrix
    [redwood.sch]
2021-10-21 Common cathode diodes reduce trace clutter
    [redwood.kicad_pcb]
2021-10-29 Footprint: solder jumper, 1 pin jumper, capacitor
2021-10-29 Footprint: SPST switch from C&K, for battery
2021-10-29 Footprint: remove unused footprints
    - diode key switch
    - angled reset switch
    - single diode
2021-10-29 Footprint: reset switch
2021-10-30 Footprint: Hillside logo scene
2021-10-30 Lib: Add capacitor, rename some symbols
2021-10-30 Battery support, Hillside logo, mounting holes
    [redwood.kicad_pcb, redwood.sch]
2021-10-30 Rename to Hillside
    [hillside.kicad_pcb, hillside.sch]
2021-10-30 doc: reset switch options, changelog
2021-10-30 Footprint: legend text larger
2021-10-31 Footprints: mounting holes
2021-10-31 Footprint font size
2021-10-31 - Footprint: logo scene change, mystery creation
2021-10-31 TRRS order has no-connect, cleanup matrix layout
    [hillside.kicad_pcb, hillside.sch]
2021-11-01 - project: gerber_hillside output dir
    [hillside.kicad_pcb]
2021-11-01 Sym/Footprint: rename logo, cleanups
    - remove unused choc-diode sym
    [hillside.sch]
2021-11-02 Common symbols/footprints used in hillside_basic
    [hillside.kicad_pcb, hillside.sch]
2021-11-02 Symbol: simplify rotary switch
2021-11-02 - cleanup schema sheet
    [hillside.kicad_pcb, hillside.sch]
2021-11-02 - cleanup via name
    [hillside.kicad_pcb]
2021-11-03 - update scheme date
    [hillside.kicad_pcb, hillside.sch]
2021-11-03 - current images for docs
2021-11-03 v0.1.0-alpha.3 Gerbers
    [hillside-B_Cu.gbr, hillside-B_Fab.gbr, hillside-B_Mask.gbr, hillside-B_SilkS.gbr, hillside-Dwgs_User.gbr, hillside-Edge_Cuts.gbr, hillside-F_Cu.gbr, hillside-F_Fab.gbr]
2021-11-09 Image of switch outlines and board edge
2021-11-12 - docs: Readme link current images. Future notes
2021-11-24 doc: Tools section, sockets as default,
2021-11-24 doc: move material and build pages to wiki
2021-12-03 Reaadme: kicad versions, footprints, name ideas
2021-12-08 readme: image of board halves side by side
2021-12-15 KiCad 6: Initial project, schema, pcb files
    [hillside.kicad_pcb, hillside.kicad_sch]
2021-12-15 - diff from doing nothing
    [hillside.kicad_pcb]
2021-12-15 - schema diff from doing nothing
    [hillside.kicad_sch]
2021-12-16 Fix unconnected segment errors
    [hillside.kicad_pcb]
2021-12-16 footprint: promicro font 1mm
2021-12-16 footprint: promicro labels further from silk lines
2021-12-16 pcb: promicro labels further from silk lines
    [hillside.kicad_pcb]
2021-12-16 Remove stitching vias now handled by islands
    [hillside.kicad_pcb, hillside.kicad_sch]
2021-12-16 pcb: route GND inside MCU footprint
    [hillside.kicad_pcb]
2021-12-17 - pcb: thousand mm changes on open in latest kicad
    [hillside.kicad_pcb]
2021-12-18 pcb: Led pads trim away from edge 0.025mm
    [hillside.kicad_pcb]
2021-12-21 Use KiCad lib mounting holes and jumper cutoff pad
    [hillside.kicad_pcb, hillside.kicad_sch]
2021-12-21 - cleanup silks
    [hillside.kicad_pcb]
2021-12-21 One fill zone for front and back ground planes
    [hillside.kicad_pcb]
2021-12-21 - ignore warnings of silk over pad
    [hillside.kicad_sch]
2021-12-21 KiCad 6 basic migration changes complete
    - diff in commit seems some random file updates
    [hillside.kicad_pcb]
2021-12-22 Remove project copies of standard lib symbols
    - R, C, Jumper, MountingHole, GND, PowerFlag,
    - Conn_01x01, Conn_01x05, SW_SPDT
    [hillside.kicad_pcb, hillside.kicad_sch]
2021-12-23 - board preferences: solder mask blue, silk white
    [hillside.kicad_pcb]
2021-12-23 Footprint: fix logo wave swell direction
2021-12-23 Smoother edgecut transition from top to pinky
    [hillside.kicad_pcb]
2021-12-23 schema: Bump version number to rev alpha
    - cleanup layout
    [hillside.kicad_sch]
2021-12-25 - schema: cleanup
    [hillside.kicad_sch]
2021-12-25 Edgecut transitions smoother
    [hillside.kicad_pcb]
2021-12-26 footprint: rotary not define internal press trace
2021-12-26 Bottom row diodes in own row, by rotating switches
    [hillside.kicad_pcb]
2021-12-26 Move MCU up to join top of index switch
    [hillside.kicad_pcb]
2021-12-26 - KiCad 6 release build diffs
    [hillside.kicad_pcb]
2021-12-27 - schema: Clean up sheet layout
    [hillside.kicad_sch]
2021-12-27 footprint: fix MCU pin to label alignment
2021-12-27 - footprint: larger font size
2021-12-27 - silkscreen cleanups
    [hillside.kicad_pcb]
2021-12-27 Bump pcb rev to 0.1.1-alpha
    [hillside.kicad_pcb]
2021-12-27 footprint: Clearer pin labels for reversible MCU
2021-12-27 footprint: Keycap outline on switches
2021-12-27 Board edgecut 0.25 mm out to match keycap outline
    [hillside.kicad_pcb]
2021-12-27 logo: adjust waves for new board edge
2021-12-27 Improve paths to ground
    [hillside.kicad_pcb]
2021-12-27 footprint: trim tenting puck text
2021-12-28 schema: Remove mounting holes for breakaway slot
    - extra stitching via
    [hillside.kicad_sch]
2022-01-02 footprint: promicro PCB to MCU alignment note
2022-01-02 Two battery pad options. PCB to MCU alignment note
    - Clearer track routing, Parallel tracks split into groups by function,
    not all clumped.
    [hillside.kicad_pcb, hillside.kicad_sch]
2022-01-13 - schema: cleanup battery wires
    [hillside.kicad_sch]
2022-01-13 pcb: pre 0.1.1-alpha
    [hillside.kicad_pcb]
2022-01-13 v0.1.1-alpha gerber files
    [hillside-B_Cu.gbr, hillside-B_Fab.gbr, hillside-B_Mask.gbr, hillside-B_SilkS.gbr, hillside-B_Silkscreen.gbr, hillside-Dwgs_User.gbr, hillside-Edge_Cuts.gbr, hillside-F_Cu.gbr]
2022-01-13 - remove gerbers
    [hillside-B_Cu.gbr, hillside-B_Mask.gbr, hillside-B_Silkscreen.gbr, hillside-Edge_Cuts.gbr, hillside-F_Cu.gbr, hillside-F_Fab.gbr, hillside-F_Mask.gbr, hillside-F_Silkscreen.gbr]
2022-01-24 Footprint: Bumpon
2022-01-24 Footprint: Mounting hole with PCB insert rings
2022-01-24 Footprint: Promicro one more row pin label
2022-01-24 Footprint: Holes of promicro for bottom plate
2022-01-24 Footprint: Holes of key switch for bottom plate
2022-01-24 - ignore file KiCad 6 notes
2022-01-24 ref: PCB threaded insert specs
2022-02-03 v0.1.1 version: doc and image update
    [hillside.kicad_pcb, hillside.kicad_sch]
2022-02-07 48: Move hillside original board into hillside48/
    [hillside.kicad_pcb, hillside.kicad_sch, hillside.sch]
2022-02-08 Split readme into family and board, tweak
2022-02-08 - re-org fixup: re-add kicad and kicad/lib
2022-02-08 Reorg: docs into 48, 48 and lib to top level
    [hillside.kicad_pcb, hillside.kicad_sch, hillside.sch]
2022-03-26 52 Hill52 Initial: copy from 56
    [hillside52.kicad_pcb, hillside52.kicad_sch]
2022-03-26 52 Initial: change 56 to 52
    [hillside52.kicad_pcb, hillside52.kicad_sch]
2022-03-26 52: Remove extra keys, Splay 5 and 10, pinky align
    [hillside52.kicad_pcb, hillside52.kicad_sch]
2022-03-27 Footprint: Switch with hotswap sized pads
2022-03-27 Footprint: Switch rotary, trim courtyard area
2022-03-27 Footprint: Logo trim wave extent
2022-03-27 Footprint: Switch rotary: hotswap pads
2022-03-27 52: Doc: Gerber readme update, drill sizes, ignore
2022-03-28 52: Hotswap footprints, cleanup tracks
    - Move base mount, and diode, closer to edge
    - PCB: tweak scale ruler, cleanup traces across splays, broken tracks
    - Scheme: Trim switch numbers, Hotswap footprints
    - Use switches with larger pads for hotswap
    - KiCad 6.0.4 and save/load churn
    [hillside52.kicad_pcb, hillside52.kicad_sch]
2022-05-09 52: Images of PCB, schematic, switches, render
2022-05-26 Tighten why description
2022-05-27 Print instructions for key layout
2022-06-14 46: Initial. Copy and file rename from 52.
    [hillside46.kicad_pcb, hillside46.kicad_sch]
2022-06-14 46: File internals refer to 46
    [hillside46.kicad_pcb, hillside46.kicad_sch]
2022-06-15 46: Remove lower row. Pinky can remove all or some
    [hillside46.kicad_pcb, hillside46.kicad_sch]
2022-06-15 46: Remove fifth LED
    [hillside46.kicad_pcb, hillside46.kicad_sch]
2022-06-15 46: Fix mask and copper alignment on board name
    [hillside46.kicad_pcb]
2022-06-15 46: Fix bump-on spots and cutout callouts
    [hillside46.kicad_pcb]
2022-06-17 46: Cleanup edge, logo, row numbers
    [hillside46.kicad_pcb, hillside46.kicad_sch]
2022-06-18 46: PCBA
    - BOM JLC part numbers, type, and cost
    - ESD protection chip
    - PCBA Tooling holes
    - Resistor values
    - Reset switch model
    - BOM excludes switches, vias, etch
    - Paste layers
    - JLC order number silk
    [hillside46.kicad_pcb, hillside46.kicad_sch]
2022-06-25 Footprint: R_0805: Fix paste layer
2022-06-25 Footprint: Tooling Hole for PCBA
2022-06-25 46: Add prices, renumber keys, LCSC Part #
    [hillside46.kicad_pcb, hillside46.kicad_sch]
2022-06-25 46: Schematic cleanup BAV70 fields
    [hillside46.kicad_sch]
2022-06-25 46: PCB scratch routing of ESD protection
    [hillside46.kicad_pcb]
2022-06-26 46: Schm: Remove thru-hole JLC part number
    [hillside46.kicad_pcb, hillside46.kicad_sch]
2022-06-26 46: PCB: Move ESD into keys area
    - Schematic layout cleanup
    [hillside46.kicad_pcb, hillside46.kicad_sch]
2022-06-26 46: Schematic: Remove 'exclude from BoM' from keys
    [hillside46.kicad_pcb, hillside46.kicad_sch]
2022-06-26 KiBot: Gerbers and drill, Docs, Initial BoM
2022-06-26 Footprint: SOT-23 dual sided hand soldered
2022-06-26 46: ESD symbol with only one data line
    [hillside46.kicad_pcb, hillside46.kicad_sch]
2022-06-27 Symbol: SVO5-4 with only one data pin
2022-06-27 46: schematic symbol property updates, costs etc
    [hillside46.kicad_sch]
2022-06-27 46: Config column marks non-components
    [hillside46.kicad_pcb, hillside46.kicad_sch]
2022-06-27 46: Optional components flagged in config field
    [hillside46.kicad_pcb, hillside46.kicad_sch]
2022-06-27 46: PCB name spacing
    [hillside46.kicad_pcb]
2022-07-06 Footprint: SOT-23-6 with only three pads numbered
2022-07-06 46: ESD sym and footprint number only three pads
    [hillside46.kicad_pcb, hillside46.kicad_sch]
2022-07-06 46: Churn in PCB build, with new KiCad version
    [hillside46.kicad_pcb]
2022-07-06 46 PCB: Better ground plane for ESD
    [hillside46.kicad_pcb]
2022-07-06 46: Update symbol descriptions, trace cleanup
    [hillside46.kicad_pcb, hillside46.kicad_sch]
2022-07-06 Footprint: Rotary ground has small pad for clarity
2022-07-06 46: Update for rotary ground pad
    [hillside46.kicad_pcb]
2022-07-06 Footprint: C_0805 fix ground plane attachment
2022-07-06 46 PCB: Ground plane and trace cleanups
    [hillside46.kicad_pcb]
2022-07-06 KiBot: build gerber on 46 file change, but not doc
2022-07-07 46 PCB: trace cleanups
    [hillside46.kicad_pcb]
2022-07-07 46: PCB connect ground on encoder. Silk tweaks
    [hillside46.kicad_pcb]
2022-07-07 46: Gerber readme in doc/, script will put in zip
2022-07-07 46 PCBA Readme
2022-07-08 46: Flip resistor to test back positioning
    [hillside46.kicad_pcb]
2022-07-08 Footprint: SOT-23 has silk layout on back
2022-07-08 Footprint: Testing puck has no courtyard
2022-07-08 KiBot: keep gerbers as a zip
2022-07-08 Footprint: C_0805 has fab layer etc on back
2022-07-08 46: PCB: SOT-23 has silk layout on back
    [hillside46.kicad_pcb]
2022-07-08 KiBot: create out dirs, zip positions, cp to pcba
2022-07-08 46: PCB Tooling hole in more from edge
    [hillside46.kicad_pcb]
2022-07-09 46: PCB top edge slopes at each finger. Hill like.
    [hillside46.kicad_pcb]
2022-07-09 46: PCB pinkie edge cut parallel with index column
    [hillside46.kicad_pcb]
2022-07-10 Footprint: Reset switch has back fab layers
2022-07-10 Footprint: SOT-23-6 ESD has back fab layers
2022-07-10 Footprint: R_0805 has back fab layers
2022-07-10 Footprint: Logo has back copper layers and mask
2022-07-10 46: PCB: PCBA components have back fab lay layers
    [hillside46.kicad_pcb]
2022-07-10 46: PCB: Breakoff routing tweak
    [hillside46.kicad_pcb]
2022-07-10 46: Date refresh for PCB and Schematic
    [hillside46.kicad_pcb, hillside46.kicad_sch]
2022-07-11 46: PCB: Second magnet edge cut circle for mount
    v0.1.0–alpha-1
    [hillside46.kicad_pcb]
2022-07-16 Fam: Readme: Board images table grouped by splay
2022-07-19 Footprint: Hole break-off for pinkie column
2022-07-19 46: Breakoff holes to ease removing pinkie column
    [hillside46.kicad_pcb, hillside46.kicad_sch]
2022-07-20 46: Readme: Photo. PCBA, Action workflows.
2022-07-22 46: PCB: Update pad footprint, attempting silk fix
    [hillside46.kicad_pcb]
2022-07-22 KiBot: Fix config. Plot footprint values.
2022-07-22 Footprint: Reset: Fab note two 1 2 pads by design
2022-07-22 Footprint: HoleBreakoff: Move text off fab layer
2022-07-22 46: Fab note for reset switch
    [hillside46.kicad_pcb, hillside46.kicad_sch]
2022-07-23 46: PCB: Trace cleanups.
    [hillside46.kicad_pcb]
2022-07-23 46: Update design sheet dates
    [hillside46.kicad_pcb, hillside46.kicad_sch]
2022-07-23 Fam: Readme: 46 PCBA
2022-08-06 46: Readme: Photo links and switch layout testers
2022-08-09 Footprint: HoleBreakoff: Label on B.Fab layer
2022-08-09 46: PCB: Cleanup labels for breaking off pinkie
    [hillside46.kicad_pcb]
2022-08-12 46: Readme: tweak encoder listing
2022-08-12 Readme: Tweak encoder locations and tester layout
2022-08-15 46: Sch: LCSC# for slide switch
    [hillside46.kicad_sch]
2022-08-15 46: Doc: PCBA fab options
2022-08-16 Workflow: PCBA script supports multiple boards
    - Doc and Fab dispatch with drop down board input
    - Fab on board path based changes
    - Better BoM column order
    - Disable switch outlines view as wacked
    - Remove PCB view as show all of ground planes
    - Doc decrease debug
    - KiBot scripts in shared bin/
2022-08-18 Footprint: Alps SPDT switch
2022-08-18 Footprint: SOT-23: Update 3D model
2022-08-18 Footprint: R_0805: Update 3D model
2022-08-18 Footprint: OLED header
2022-08-18 Footprint: LED 0805 one color
2022-08-18 Footprint: C_0805: Update 3D model
2022-08-18 Footprint: Logo: Remove paste layer
2022-08-19 Footprint: SPDT slide: elipse pins more general
    - Support 3.3 and 3.4 mm row separation components
2022-08-19 KiBot: Purpose field in BoM. Position only if LCSC
    - Position file for SMT and through-hole
2022-09-01 .gitignore */temp/ and */gerbers/
2022-09-07 Foot: Power switch: Mask over center, B/F silks
2022-11-01 52: Update after rebase on symbol libs, new KiCad
    [hillside52.kicad_pcb, hillside52.kicad_sch]
2022-11-01 52: Add missing PCBA part numbers, 'do not fit'
    [hillside52.kicad_pcb, hillside52.kicad_sch]
2022-11-01 52: PCBA: Rotate power switch footprint. Prices
    [hillside52.kicad_pcb, hillside52.kicad_sch]
2022-11-01 52: PCB: Update footprints for PCBA guide silks
    [hillside52.kicad_pcb]
2022-11-01 52: PCBA Tooling holes, rev bump, JLC number silk
    [hillside52.kicad_pcb, hillside52.kicad_sch]
2022-11-03 Foot: SPDT power switch: origin at center for PCBA
2022-11-03 52: Power switch origin at center for PCBA
    [hillside52.kicad_pcb]
2022-11-03 Workflow: PCBA tweak origin and rotations
    - Pos file not use aux axis for JLC
    - Bottom rotation is negative of top
    - BAV70 bottom rotation gets extra 180
2022-11-03 52: Bump Hillside 52 version to 0.1.1-rc1
    [hillside52.kicad_pcb, hillside52.kicad_sch]
2022-11-03 Readme: 52 has PCBA
2023-02-12 Readme: Prebuilt and case options
2023-09-19 docs(readme): clarify Mill-Max hotswap sockets
